MattGrayYes/Rainbow-Star-Christmas-Tree-Topper/3D Files/Matt Gray - Star Tree Ornament - Base Bottom.stl

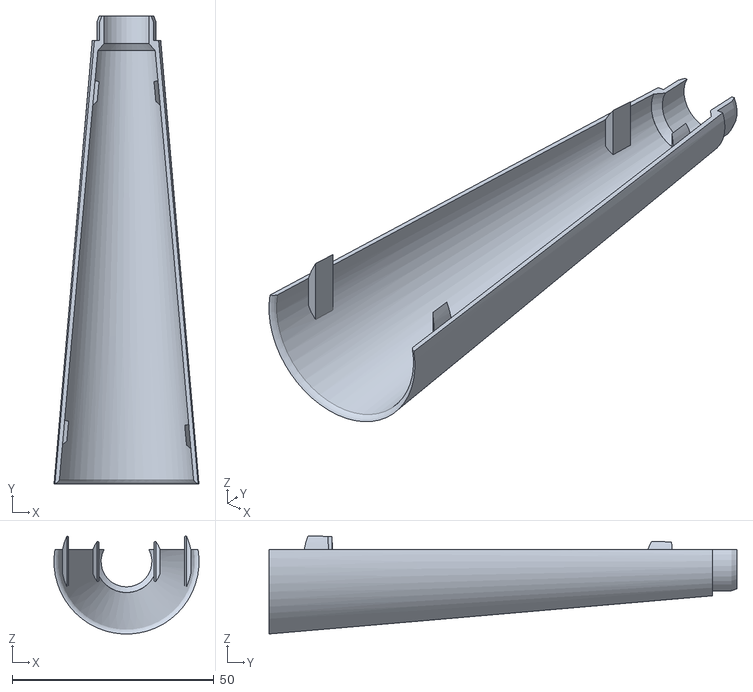
[picture p1: CAD file, 2024-12-08]
3D Files/Matt Gray - Star Tree Ornament - Base Bottom.stl
36.0 x 116.0 x 24.3
