MattGrayYes/Rainbow-Star-Christmas-Tree-Topper/3D Files/Matt Gray - Star Tree Ornament - Star Lid.stl

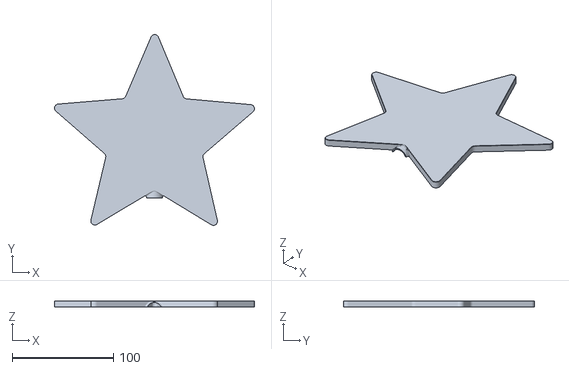
[picture p2: CAD file, 2024-12-08]
3D Files/Matt Gray - Star Tree Ornament - Star Lid.stl
197.7 x 188.6 x 6.00
