MattGrayYes/Rainbow-Star-Christmas-Tree-Topper/3D Files/Matt Gray - Star Tree Ornament - Base Top.stl

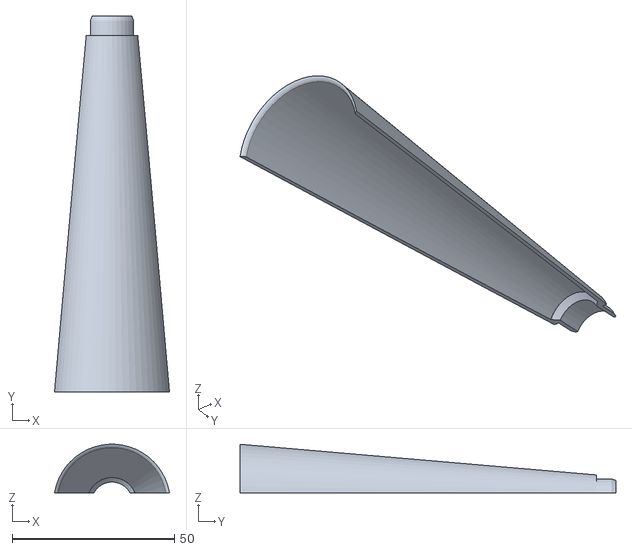
[picture p3: CAD file, 2024-12-08]
3D Files/Matt Gray - Star Tree Ornament - Base Top.stl
35.5 x 116.0 x 15.0
