MattGrayYes/Rainbow-Star-Christmas-Tree-Topper/(list of files, cad)

Other CAD files:
3D Files/Matt Gray - Star Tree Ornament.f3d
