MattGrayYes/Rainbow-Star-Christmas-Tree-Topper/Assembly/Assembly 1 - Glue Base Bottom to Star Body.png

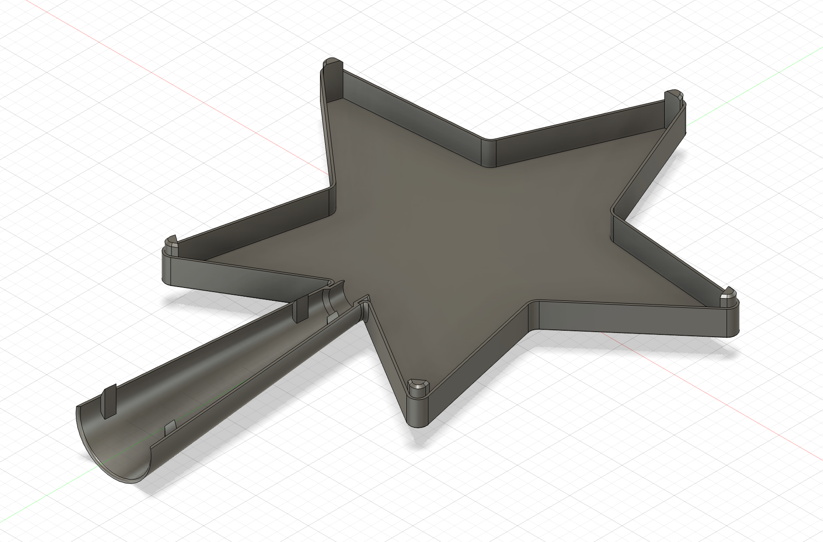
Assembly/Assembly 1 - Glue Base Bottom to Star Body.png
