MattGrayYes/Rainbow-Star-Christmas-Tree-Topper/Assembly/Assembly 2 - Glue Star Top to Star Body.png

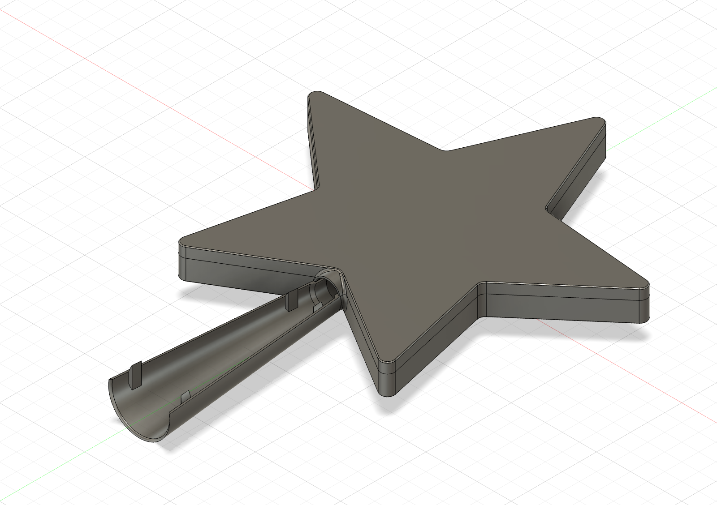
Assembly/Assembly 2 - Glue Star Top to Star Body.png
