MattGrayYes/Rainbow-Star-Christmas-Tree-Topper/Assembly/Assembly 3 - Glue Base Top to Base Bottom.png

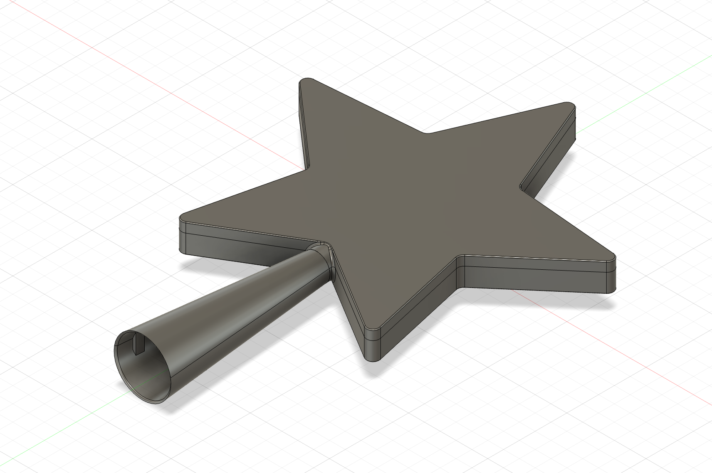
Assembly/Assembly 3 - Glue Base Top to Base Bottom.png
